FRCTeam3206/Electrical/README.md

# Electrical
Container for Electrical team.  Includes to-do, issues, shopping, coordination and communication.
Location for Arduino code for 80/20 bots and Zumos.
