FRCTeam3206/Electrical/Neopixel-Length-Finder-main/README.md

# Neopixel-Length-Finder
Determines how many LED's there are in a Neopixel strip
