FRCTeam3206/Electrical/WiringDiagrams/readme.txt

Try to use Fritzing software to create wiring diagrams.
https://fritzing.org/download/

Review the overview at https://www.youtube.com/watch?v=Hxhd4HKrWpg
Review Tutorials at https://fritzing.org/learning/
