FRCTeam3206/Electrical/WiringDiagrams/51ujpg+CBlL._SL1000_.jpg

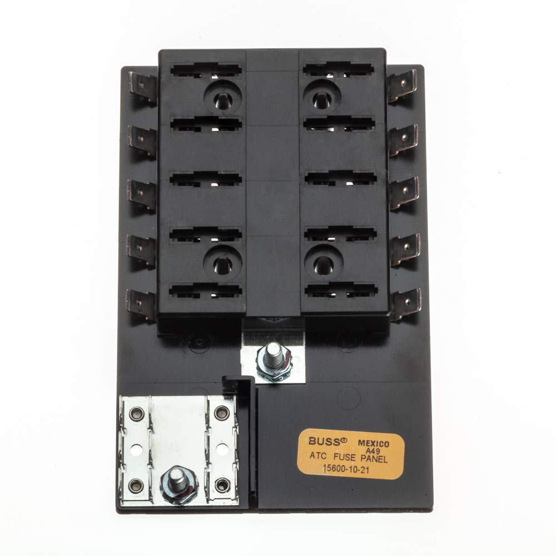
WiringDiagrams/51ujpg+CBlL._SL1000_.jpg
