FRCTeam3206/Electrical/(threads)

Thread 1 (2016-03-15):

CAD model for Power Distribution board ( 3 )

RajGandhi, 2016-03-15:
This could be assigned to one or more people.  At a minimum, one single adequate model should be created.

It would be a bonus to have multiple models created to determine best design.

Assign to Jessica  & Alex.

RajGandhi, 2016-03-22:
Include BOM.

RajGandhi, 2017-02-23:
This already exists.  Cancel.

Closed 2017-02-23.

Thread 2 (2016-03-15):

Shopping List (ongoing)

RajGandhi, 2016-03-15:
Buy USB cameras from Amazon.  Qty 2.

RajGandhi, 2016-03-15:
Assigned Rob.  This is experimental.  Feel free to ignore GitHub spam.

RajGandhi, 2016-03-19:
Nothing on current shopping list.

RajGandhi, 2016-03-22:
Potentiometer for intake.  Digikey. 1/4" shaft (long). 10k (doesn't matter much). Heavy-duty.  Shaft all the way through would be nice.

RajGandhi, 2016-03-25:
Don't need pot or other parts.  We have enough stuff on-hand.

Closed 2016-05-14.

Thread 3 (2016-03-15):

Improve motor for intake ( 1 )

RajGandhi, 2016-03-15:
Needs gears.  3-d printed?

Gear ratio?

Replace with snow-blower motor and new gears?

RajGandhi, 2016-03-19:
Install printed gears.

RajGandhi, 2016-03-21:
RS550 motor with small forward: 1V, 5A.

RajGandhi, 2016-03-22:
Mini CIM motor with ~1:1 round pulley is fast but doesn't hold the ball in-place.  The intake moves by-hand easily.  Possibly adjust the hold / stall voltage.  -- It is probably fundamentally bad to deliberately hold a DC motor at stall.

RajGandhi, 2016-03-24:
Mini CIM w/ pulley 2.5":3.4".  Complete failure and a disappointment to its parents.

Pull-in was fast.  Eject was fast.
Stalling still occurs until limit switch is actuated; something odd happened with code and stall happened and it didn't eject.

RajGandhi, 2016-04-11:
Different gears from McMaster(?) were used.

Closed 2016-04-11.

Thread 7 (2016-03-19):

Finalize Limit Switch ( 2 )

RajGandhi, 2016-03-19:

RajGandhi, 2016-03-22:
Try 3D printed mount to intake sheet metal.  Angle of intake is 67 deg.  Print two pieces.  One mates with sheet metal; use microswitch hole spacing.  One is corner angle which mates to first piece and microswitch.  Initially, could use just the first 3D printed piece.

RajGandhi, 2016-03-22:
It would be possible to improve the lever and pivot.  The 80/20 hinge is a possibility with 1/4" threaded rod and 3D printed mount.

It might be elegant to use a potentiometer as the pivot and thereby read position at the same time.  The application might be too rough; shaft coupled and bearings might be worth the effort.

RajGandhi, 2016-03-23:
Print the T-shaped piece shorter.  4 holes is good enough.  More is too long.

RajGandhi, 2016-03-24:
Consider changing the limit switch to a rotational position (angle) sensor by using a pot on-axis with a hinge.  Need to buy pot (1/4" shaft) 1/4" plastic rod, bearings.  3D print physical adapters.

RajGandhi, 2016-03-25:
Pot works well enough.  3d print a single holder for Pot + bearing.

RajGandhi, 2016-04-11:
Pot would have been nice but the short range of motion would have caused some resolution issues.  Creative use of a current source might have solved that issue but with added cost of complexity.

Microswitch was good enough.

Closed 2016-04-11.

Thread 12 (2016-05-14):

Systems / Electrical plan through school start Fall 2016

RajGandhi, 2016-05-14:
(Jessica's) For through summer:

Monday (as the basis), two hour meetings (taking into account learning experiences along the way).

May 16th- Discuss thoughts for wiring and layout for next year, start work on the controller and work with breadboards

May 23rd- Continue work on controller board

May 30th- Wrap up work on controller board (?) - play with pneumatic capabilities

--meet on other day, possibly programming, in order to complete controller board

June 3rd- Possible Programming collaboration with arduino project

Skip June 6th due to it being finals (?)(could be nice to get in extra day, but attendance would be hard)

June 13th- Testing of controller board, arduino projects

June 17th- Meet on programming day to finish arduino projects if needed (or wanted)

---- June 18th-August 1st

I send super cool emails to do with systems-online resources to familiarize with wiring and components, maybe to make into a really fun format so people will actually read it- and encourage attendance at programming and mechanical meetings.
---

August 2nd- Practice design layouts for electrical components, work with some older components and extras to practice wiring, make a project out of it--a shooter mechanism, something involving wiring motors

August 8th- People make cool stuff

August 15th- Wrap up and talk about upcoming year

(Possibility to space out previous meetings more or add more content)
## Crimping training included when there is extra time, or too many people working on one thing

School Starts on the 6th- are we going to have a current whole team meeting after the school year starts to discuss plan and how to recruit people?

I maybe got a little too specific, but I thought as the end of the school year is approaching having a more solid idea of where and when to start would be good.  If more time is needed to prepare for the controller, then some independent pneumatics could get interesting or just having a blast with breadboards. Let me know what you think and how your schedule works with this rough sketch.

Arduino projects- probably start off with some basics and then try to have designs with more purpose-like the turret

Daniel-Thalman, 2016-05-14:
So that is why you have been there on mondays

RajGandhi, 2016-05-14:
Yes but not exactly causal.  The plan is from Jessica.  Apparently her schedule is better on Mondays than most days.

Last week we received the club's RFID board and it seemed like a good idea to have it soldered and ready to go for Thursday to support programming.  Monday was basically the only/best day to get the work done.

For upcoming Monday, 5/16, planning to meet 6-7:30pm.

Closed 2016-11-01.

Thread 13 (2016-05-17):

Arduino Controller Board

jessicamd, 2016-05-17:
Here is the picture of the board from the 5/16/16 Systems Meeting. We are going to use an attached power supply ($30) for the board (a battery can still be used if needed) and an IO expander ($12) in order to allow for more LEDs to indicate switch statuses. A mix of TALONS and VICTORS will serve for the 4 motor controllers and there will be a pneumatic board which can attach to the Arduino via a CAN shield ($25).

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

RajGandhi, 2016-05-24:
Moved new issue from JD:

> For the 5/23 meeting we started to CAD the board, we will continue on next meeting and try to start constructing the board. Pneumatics for the sub-board need to be gathered and discussed. Also, an IO expander and CAN shield should arrive shortly. Red and yellow LEDs have arrived, green will be ordered. We have the power supply and will reuse the polycarbonate.

Thread 14 (2016-05-22):

Arduino Getting Started

RajGandhi, 2016-05-22:
This issue is a set of instructions for getting started with Arduino.  It will cover initial hardware setup, software setup and library setup.  When this issue is well documented it can be migrated to the Wiki.

Arguably this could go in programming or electrical because it is a mix of hardware and software.

**Lesson 1: Get the Arduino development software and install.**
Go to Arduino.cc and go to the [Download](https://www.arduino.cc/en/Main/Software) page.  Select the correct installation for your environment.  Usually it will be the Windows Installer.  As of this writing, the most current version is 1.6.9.  On the following page, there's a donation page; donate or click on "just download".

Install the software by navigating to the download location and execute the program (arduino-1.6.9-windows.exe or similar).  If prompted, allow un-installation of previous version of Arduino software.

**Lesson 2: Connect to PC and confirm**
Using the appropriate USB cable, plug the Arduino board into the PC.  Launch the Arduino software.

Open the Blink example program.

Select the correct Arduino board.

Select the correct "Port"

Compile and upload the program.  Observe blink 1 second on then 1 second off.  Modify code to make it blink faster.

**Lesson 3: Use Serial Monitor to Assist Debugging**
Modify blink code to use serial monitor.

**Lesson 4: Install a library**
Neopixel or stepper shield

Future lessons that are relevant to robotics:
 - PWM speed control
 - potentiometer input
 - microswitch input
 - interrupt input
 - temperature input
 - Other LED output
 - relay output

RajGandhi, 2016-11-04:
11/3/2016 - latest version of Arduino IDE is 1.6.12.

Thread 15 (2016-05-24):

Arduino Board CAD

jessicamd, 2016-05-24:
For the 5/23 meeting we started to CAD the board, we will continue on next meeting and try to start constructing the board. Pneumatics for the sub-board need to be gathered and discussed. Also, an IO expander and CAN shield should arrive shortly. Red and yellow LEDs have arrived, green will be ordered. We have the power supply and will reuse the polycarbonate.

RajGandhi, 2016-05-24:
Merged this issue with existing Arduino Controller Board issue.

Closed 2016-05-24.

Thread 16 (2016-05-31):

Team Laptop

RajGandhi, 2016-05-31:
The existing team drive-station laptop may not be adequate for next season.  It was upgraded to Windows 10 and now LabView takes a _long time_ to do ordinary tasks.

Where is the touch-screen laptop and what is that status?

It is probably a good idea to start the search process for the next laptop, just in case it is necessary.
Needs:
- Runs latest LabView
- Runs latest Eclipse & Java
- Runs Autodesk Inventor 2015 (that's our standard, right?)
- Upgraded to Windows 10

Wants:
- 16 Gb system RAM (8 Gb might be okay but is there much of cost difference?)
- 500 Gb SSD (250 Gb SSD might be  adequate; spinning hard drive is slower and less reliable)
- 15" Screen (is 17" too big for driver station and 13" too small for development?)
- video co-processor with 2 Gb video ram
- Windows 10 native (upgrading to Windows 10 is a hassle)

Raj's big laptop is a MacBook Pro 15 2013 that dual-boots to Windows 7.  The hardware specs are good and it runs LabView, Eclipse and Inventor fine.  Cost is too high and the Windows OS lacks refinement (i.e. the drivers aren't well tuned).  There are shut-down issues and wake-ups will sometimes lose the keyboard.

Without any justification, here's a link to the [MacBook Pro 15 2015 review](http://www.notebookcheck.net/Apple-MacBook-Pro-Retina-15-Mid-2015-Review.144402.0.html).  More importantly is the concluding paragraph that mentions competitors:
If you are still undecided between the MacBook and the Windows alternatives like the [Asus ZenBook Pro](http://www.notebookcheck.net/Asus-ZenBook-Pro-UX501JW-Notebook-Review.142308.0.html), the [Acer Aspire V 15 Nitro](http://www.notebookcheck.net/Acer-Aspire-V15-Nitro-Black-Edition-VN7-591G-Notebook-Review.140919.0.html) or the [Asus G501JW](http://www.notebookcheck.net/Asus-G501JW-Notebook-Review.141745.0.html), which have been available for quite a while now... The battle for the first spot in our [Top 10 ranking](http://www.notebookcheck.net/Notebookcheck-s-Top-10-Multimedia-Notebooks.98608.0.html) remains exciting.

Chief Delphi [thread 1](http://www.chiefdelphi.com/forums/showthread.php?t=148135) and [thread 2](http://www.chiefdelphi.com/forums/showthread.php?t=140733).

Autodesk Inventor [certified hardware search tool](http://usa.autodesk.com/adsk/servlet/syscert?id=18844534&siteID=123112).  All of these results include Quadro video cards and, as a result push the price too high, $2k or so.  Carolyn would like a 2nd laptop capable of Inventor.  The "certified hardware" is probably more than adequate and can't justify the extra $1k.  Anything with a video co-processor is probably going to be adequate.  Raj's laptop has a [NVIDIA GeForce GT 750M](http://www.notebookcheck.net/NVIDIA-GeForce-GT-650M.90245.0.html) that is known to be adequate.

It appears that the Acer line might be the best value.  Something that meets all the Needs and some of the Wants should be available in the $600 to $900 range.  Consider purchasing options including Best Buy, NewEgg, Amazon.

It would be nice to find someone with personal experience with one of the (Acer) laptops.  If a good choice can be found, the team can make the recommendation to the greater team and possibly buy two for the team.

Daniel-Thalman, 2016-05-31:
For development screen size dosn't matter ie i use a 11 inch air and the screen is no hinderence

RajGandhi, 2016-06-03:
Not specifically a recommendation, just research notes.

Asus ROG GL 552 gaming laptop [review](http://www.laptopmag.com/reviews/laptops/asus-rog-gl552#)
Asus [site](https://www.asus.com/ROG-Republic-Of-Gamers/ROG-GL552JX/Features/); about $1000 on NewEgg
Graphics [Nvidia GeForce GTX 960M](http://www.notebookcheck.net/NVIDIA-GeForce-GTX-960M.138006.0.html) 2GB of VRAM

[Cheaper version](http://www.newegg.com/Product/Product.aspx?Item=N82E16834232946) on NewEgg, $679
Asus [site](https://www.asus.com/Notebooks/K501UX/)
Graphics [NVIDIA GeForce GTX 950M](http://www.notebookcheck.net/NVIDIA-GeForce-GTX-950M.138026.0.html)

RajGandhi, 2016-06-07:
Existing team laptop is [Lenovo U530](http://www.notebookcheck.net/Review-Lenovo-IdeaPad-U530-Touch-Notebook.115269.0.html)

According to the specs it is pretty good: i7, dual core (four logical cores), dual video processors (Nvidia GT 730M), 8Gb, 1 Tb HDD with 600+ Gb free.

RajGandhi, 2016-10-06:
Roger, can you make a recommendation based on some of the above notes?

Daniel-Thalman, 2016-10-06:
My 2013 13 inch MacBook Air dual boots to Win 10 and has no more issues then a native Win 10 but also include extra cost of Windows in price. Which is about $100

Sent from my iPhone

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

RajGandhi, 2016-11-04:
Purchased.

Closed 2016-11-04.

Thread 17 (2016-11-01):

Add repository for Arduino temp sensor

RajGandhi, 2016-11-01:
Raj has this software and libraries in a few parts.
 - Color LED
 - Read temperature sensor.

RajGandhi, 2016-11-04:
Files aren't attached?   Fix that.

RajGandhi, 2016-11-04:
Fixed.

Closed 2016-11-04.

Thread 18 (2016-11-10):

Arduino Temperature Sensor mini-Project

RajGandhi, 2016-11-10:
Purpose - eventually provide real-time monitor of CIM motor temperature.  As a stepping-stone, do data logging with an Arduino and temperatures sensors.

1. Attach the sensor to PWM female header. Note, need to swap one wire.  Label header. (Requires soldering and crimping.)
2. Build PWM extension cable. One PWM male & one PWM female.  (Requires crimping.)
3. Temporarily attach temp sensor to motor.  Test with Arduino.
3. Repeat for all motors.
4. Test with Arduino, multi-channel input.
5. Add data logging in Arduino to SD card. (Bonus)

RajGandhi, 2016-11-10:
In the "Code" section, Eval Temp Sensor is good start / test code.

Thread 19 (2016-11-10):

Mini Bots - Zumo Bot

RajGandhi, 2016-11-10:
To do: archive some of the code here.

Add to do list for improvements / add-ons.
 - Vbat montior (use on-board A1; change v_divider from 2/3 to 1/2)
 - implement buzzer
 - add temp sensor using PWM headers
 - add dual laser holders, motor driver, DIO
 - remove some stuff; arduino power port, some header pins, change arduino to stacking header pins

RajGandhi, 2016-11-11:
Buzzer works.

RajGandhi, 2016-11-11:
SD card (CAN shield) doesn't work on the Zumobot.  There's a conflict with DIO pin 8 "CS" on the SD card (CAN shield) and the Zumobot.  Zumobot uses DIO pin 8 for motor control.  See ref docs:
https://www.pololu.com/docs/pdf/0J57/zumo_shield_for_arduino.pdf
Zumomotors.cpp and Zumomotors.h

RajGandhi, 2016-11-11:
Not many IO lines are available after Zumo. DIO6, DIO11 are available.  Maybe DIO2.  Probably DIO 0 and 1 are available.

A0, A2 and A3 are available.

RajGandhi, 2016-11-14:
Vbat monitor is challenging because it can't be tested while plugged-in to a USB port. Try this:
 - implement a single beep
 - implement a single beep from push button
 - implement beep from pushbutton that corresponds to battery voltage.

RajGandhi, 2016-12-13:
Try to make a better and battery saving laser driver using a DRV8838 dc motor driver.

RajGandhi, 2016-12-14:
Laser Software.

1. Try to output 10% duty cycle constant.  Check polarity and voltage.  Voltage will probably be high no-load.

Works.  Default is dim.  Level-change is tied to button press.  There's an interaction the tones emitted for battery voltage.  It works but not quite as expected.

To do: move input for Laser level change to a different DIO and control it remotely (transceiver).
