FRCTeam3206/Electrical/(list of files, drawings)

Other design files:
WiringDiagrams/HolonomicDrive-Fall2019.fzz
