FRCTeam3206/Electrical/Eval_Zumo_SD_CardInfo/Eval_Zumo_SD_CardInfo.ino

/*
  SD card test

 This example shows how use the utility libraries on which the'
 SD library is based in order to get info about your SD card.
 Very useful for testing a card when you're not sure whether its working or not.

 The circuit:
  * SD card attached to SPI bus as follows:
 ** MOSI - pin 11 on Arduino Uno/Duemilanove/Diecimila
 ** MISO - pin 12 on Arduino Uno/Duemilanove/Diecimila
 ** CLK - pin 13 on Arduino Uno/Duemilanove/Diecimila
 ** CS - depends on your SD card shield or module.
 


 created  28 Mar 2011
 by Limor Fried
 modified 9 Apr 2012
 by Tom Igoe
 Modified Nov 2016
 by Raj Gandhi -- This works with a Uno compatible and CAN shield (with SD card)
 It was challenging to FAT32 format the 2Gb card corrctly and make it all work.  
 
 */
// include the SD library:
#include <SPI.h>
#include <SD.h>

// set up variables using the SD utility library functions:
Sd2Card card;
SdVolume volume;
SdFile root;

// change this to match your SD shield or module;
// Arduino Ethernet shield: pin 4
// Adafruit SD shields and modules: pin 10
// Sparkfun SD shield: pin 8
// RG: pin 8 or 9 are correct for the Sparkfun CAN shield.  I don't know why both work in sw.  According to schematic it is pin 9.
// RG: cut and jump to make pin 6 work.
const int chipSelect = 6;
/***
RG: The Zumo uses DIO8 for motor right.  That means there's a conflict using pin 8 for the SD card.
All is not lost.  There are two methods for controlling the Zumobot motors.  I think we're using the PWM inputs
on pins 9 and 10 rather than pins 7 and 8.

To do: verify that we're using pins 9 and 10.  Then cut pin 8 on the header that goes to the Zumo.
The solution would probably be to find and cut the line to 8 after ensuring.
Resolution: Zumo schematic says it is using pins 7, 8, 9 and 10 for motors.

Resolution: Cut pin 9 between Arduino and CAN shield.  On CAN shield, solder a jumper between pin 6 and 9.
Tested and works.  (Zumo pin 6 is guaranteed available because we're using 3 for buzzer.)

Note, there might be more conflicts.  Pin 6 on Zumo is supposed to be for an LCD but we don't have an LCD or plans
to add one.

***/
void setup() {
  // Open serial communications and wait for port to open:
  Serial.begin(9600);
  while (!Serial) {
    ; // wait for serial port to connect. Needed for native USB port only
  }


  Serial.print("\nInitializing SD card...");

  // we'll use the initialization code from the utility libraries
  // since we're just testing if the card is working!
  if (!card.init(SPI_HALF_SPEED, chipSelect)) {
    Serial.println("initialization failed. Things to check:");
    Serial.println("* is a card inserted?");
    Serial.println("* is your wiring correct?");
    Serial.println("* did you change the chipSelect pin to match your shield or module?");
    return;
  } else {
    Serial.println("Wiring is correct and a card is present.");
  }

  // print the type of card
  Serial.print("\nCard type: ");
  switch (card.type()) {
    case SD_CARD_TYPE_SD1:
      Serial.println("SD1");
      break;
    case SD_CARD_TYPE_SD2:
      Serial.println("SD2");
      break;
    case SD_CARD_TYPE_SDHC:
      Serial.println("SDHC");
      break;
    default:
      Serial.println("Unknown");
  }

  // Now we will try to open the 'volume'/'partition' - it should be FAT16 or FAT32
  if (!volume.init(card)) {
    Serial.println("Could not find FAT16/FAT32 partition.\nMake sure you've formatted the card");
    return;
  }


  // print the type and size of the first FAT-type volume
  uint32_t volumesize;
  Serial.print("\nVolume type is FAT");
  Serial.println(volume.fatType(), DEC);
  Serial.println();

  volumesize = volume.blocksPerCluster();    // clusters are collections of blocks
  volumesize *= volume.clusterCount();       // we'll have a lot of clusters
  volumesize *= 512;                            // SD card blocks are always 512 bytes
  Serial.print("Volume size (bytes): ");
  Serial.println(volumesize);
  Serial.print("Volume size (Kbytes): ");
  volumesize /= 1024;
  Serial.println(volumesize);
  Serial.print("Volume size (Mbytes): ");
  volumesize /= 1024;
  Serial.println(volumesize);


  Serial.println("\nFiles found on the card (name, date and size in bytes): ");
  root.openRoot(volume);

  // list all files in the card with date and size
  root.ls(LS_R | LS_DATE | LS_SIZE);
}


void loop(void) {

}
