FRCTeam3206/Electrical/(commit log)

2016-11-11 Changed CS pin
    Modified hardware and changed CS pin to 6 in SW. Added documentation.
2016-11-15 Functional
    This functional but mostly example code. The program reads Vbat and
    beeps back the voltage. There's a quick two beep to ack. Then one beep
    per volt then, at a higher pitch, one beep per tenth of a volt. The
    intent is to play warning beep message when Vbat is too low in order to
    conserve LiIon batteries.
    [Eval_Zumo_VBat.ino]
2016-11-15 Added Vbat tones
    Zumo button press emits tones that correlate to Vbat.
2016-11-24 Added Eagle CAD (PC board) files.
    [ADC I2C.sch, Battery Charger.brd, Battery Charger.sch, Battery Monitor.sch]
2016-12-14 Lasers are working.
2017-01-17 Initial archive
    Controls motor speed by potentiometer.
2017-02-23 Remove the project from FRC3206
    Move to Raj's local.
    [Battery Charger.brd, Battery Charger.sch, Battery Monitor.brd, Battery Monitor.sch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]
2017-06-03 Low Battery Detect
    Working on implementation of low battery detection.
2018-04-23 Fixed RC controller
    Swapped throttle and steering inputs. Added RSL feature (health blink)
    on pin 13 LED.
    [Eval_Zumo_RC.ino]
2018-08-27 Refactored Throttle and Steering calculations
    Added accel limit with IIR filter for Throttle. Removed some Deadband
    because not needed. Scaled Steering so steering isn't as sensitve. The
    change should make it easier to drive without tipping. Some risk that
    there's an accidental decrease in max speed.
2018-12-08 Finished implementation of throttle and steering smoothing
2018-12-14 Made improvements to stability
    [Eval_RC_Mecanum.ino]
2019-09-15 Fixed steering implemented aux pin
    Changed steering pin
    made accel limited dependant on aux button
2019-09-30 Added Blinking light
    When in normal mode, light blinks normally, once button is pressed light blinks faster
2019-10-12 Create WiringDiagrams
2019-11-19 Introduce small step delays
    Rather than delaying in switch statement for each STATE, make each
    "state" a function that returns whether or not it is currently
    "running" based on elapsed time. If a state function returns 0, call a
    function to set the next state and reset the elapsed timer. End with
    stopped bot, ready for teleop.
    [Eval-RC_Pistol_Auton_StepwiseDelay.ino]
2021-11-07 Update Simple_RC_PistolGrip.ino
    - Added code to convert RC inputs to motor outputs
    - Separated debugging output code into function debug_output
    - debug_output accepts can show either the input or output values
2021-12-05 Fixed debug delay logic
    [Simple_RC_PistolGrip.ino]
2021-12-07 Base dbg_delay on the current millis()
2021-12-07 Fixed stray negative sign
    [Simple_RC_Tank.ino]
